doctormord/Overfill-prevention-sensor-test-ESP32/tools/report-generator/index.html

# GWG Report — Grenzwertgeber / overfill prevention sensor

Reads the tester over Web Serial and writes an A4 test report as PDF. Works offline, no dependencies.

## 1 · Daten / data

Serial verbinden Logdatei öffnen

Log

Noch keine Daten.

Log speichern Leeren

## 2 · Prüfobjekt / unit under test

Typ

Hersteller

Serien-Nr.

Baujahr

Anlage / Einbauort

## 3 · Prüfbedingungen / conditions

Datum

Uhrzeit

Umgebungstemperatur °C

rel. Feuchte %

Prüfer

Bericht-Nr.

Messmittel und Rückführung

## 4 · Bericht / report

Sprache / language Bemerkungen / remarks

PDF erzeugen Herunterladen

## Messwerte / parsed values

Keine Daten geladen.

## Vorschau / preview
