doctormord/Overfill-prevention-sensor-test-ESP32/docs/example-report/page2.png

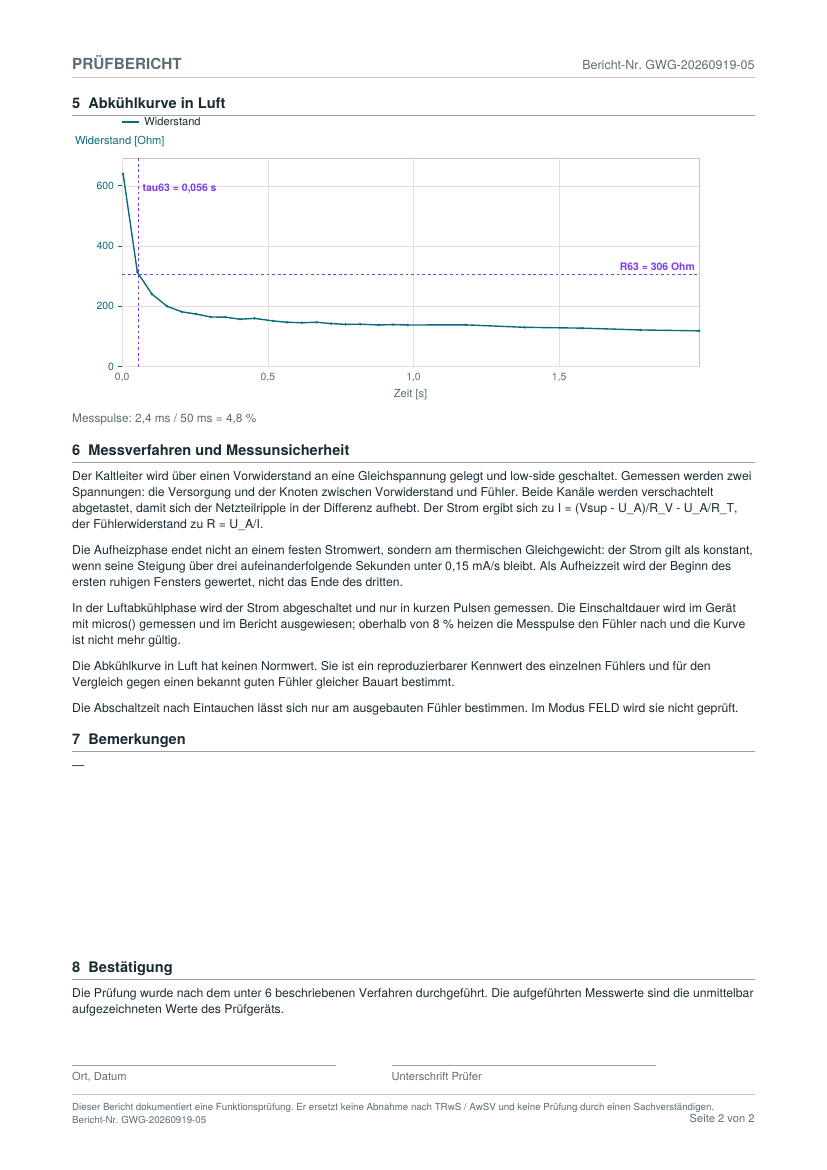
docs/example-report/page2.png
