doctormord/Overfill-prevention-sensor-test-ESP32/hardware/gwg-tester.kicad_sch

## KiCad design hardware/gwg-tester.kicad_sch (2026-11-05)

Schematic: gwg-tester.kicad_sch

Parts:
C1, C2: 10n; not fitted
GND1, GND2, GND3, GND4, GND5, GND6, GND7, GND8: GND
J1: 19V DC in
J2: probe
MOD1: TTGO T-Display
PWR1, PWR2, PWR3: +19V
R1: 159R; see note 1
R2: 1M
R3: 220R
R4, R6: 100k
R5, R7: 10k
U1: CPC1906Y

Notes on the sheet:
Note 1 R1 = 159.1 R, measured -- not read off a colour code and not
back-calculated from the two ADC channels. Build it from standard
values and measure the result:
6 x 1k parallel = 166.7 R 0.10 W each
3 x 470R parallel = 156.7 R 0.21 W each
Enter the measured value in firmware/gwg_tester/config.h as R_SERIES.
Note 2 C1 and C2 are DNP. If fitted, fit BOTH with the same value: the
current is the difference of the two channels, so asymmetric
filtering feeds the full supply ripple into the current reading
instead of cancelling it. A capacitor on node A alone also stretches
the settle time and blocks the pulsed measurement while cooling.
Note 3 Tie the 19 V supply ground to module ground. Power MOD1 from USB-C,
not from the 19 V rail.
Note 4 R2 keeps a defined current flowing with no probe fitted, so
open-circuit detection cannot read a plausible value off a floating
node. It is divided out in firmware: R_DIV_A = 110k || 1M = 99.1k.
Note 5 GPIO32/33 are on ADC1. ADC2 is unusable while WiFi is active.
GPIO0 and GPIO35 are the on-board buttons, no external wiring.
WARNING Not intrinsically safe. Do not test in fuel oil or a hazardous area.
